Om1903/Design-and-Simulation-of-an-EEG-Alpha-Wave-Extraction-Circuit-with-Notch-Filtering/Final Schematic.asc

B2: bv; V =  200m + 500m * sin(2*pi*50*time)
B3: bv; V = 0
B4: bv; V =  200m + 500m * sin(2*pi*50*time)
C1: cap; 0.2µ
C2: cap; 1µ
C3: cap; 1µ
C4: cap; 0.2µ
C5: cap; 0.1µ
C6: cap; 0.1µ
C7: cap; 1µ
C8: cap; 1µ
C9: cap; 0.1µ
C10: cap; 0.1µ
C11: cap; 1µ
C12: cap; 1µ
C13: cap; 1µ
C14: cap; 1µ
C15: cap; 1µ
C16: cap; 1µ
C17: cap; 1µ
C18: cap; 1µ
C19: cap; 1µ
C20: cap; 1µ
C21: cap; 1µ
C22: cap; 1µ
C23: cap; 1µ
C24: cap; 1µ
C25: cap; 0.2µ
C26: cap; 0.1µ
C27: cap; 0.1µ
C28: cap; 1µ
C29: cap; 1µ
C30: cap; 1µ
C31: cap; 1µ
C32: cap; 1µ
C33: cap; 1µ
C34: cap; 1µ
C35: cap; 1µ
R1: res; 10k
R2: res; 10k
R3: res; 10k
R4: res; 25k
R5: res; 1k
R6: res; 586
R7: res; 25k
R8: res; 10k
R9: res; 10k
R10: res; 10k
R11: res; 10k
R12: res; 10k
R13: res; 10k
R14: res; 10k
R15: res; 10k
R16: res; 10k
R17: res; 5k
R18: res; 31.8k
R19: res; 31.8k
R20: res; 16.5k
R21: res; 58.4k
R22: res; 2.21k
R23: res; 10k
R24: res; 1k
R25: res; 10k
R26: res; 10k
R27: res; 118k
R28: res; 10k
R29: res; 10k
R30: res; 10k
R31: res; 1k
R32: res; 10k
R33: res; 31.8k
R34: res; 31.8k
R35: res; 16.5k
R36: res; 25k
R37: res; 1k
R38: res; 10k
R39: res; 10k
R40: res; 586
R41: res; 1k
R42: res; 10k
R43: res; 10k
R44: res; 586
R45: res; 1k
R46: res; 586
R47: res; 25k
R48: res; 28k
R49: res; 1k
R50: res; 10k
R51: res; 7.5k
R52: res; 7.5k
R53: res; 10k
R54: res; 1k
R55: res; 25k
R56: res; 1k
R57: res; 1k
R58: res; 25k
R59: res; 5k
R60: res; 1k
R61: res; 1k
R62: res; 10k
R63: res; 10k
R64: res; 10k
R65: res; 885
R66: res; 185k
R67: res; 43.3k
R68: res; 1.34k
R69: res; 302k
R70: res; 10k
R71: res; 10k
R72: res; 10k
R73: res; 10k
R74: res; 10k
R75: res; 10k
R76: res; 10k
R77: res; 1k
R78: res; 10k
R79: res; 31.8k
R80: res; 31.8k
R81: res; 16.5k
R82: res; 10k
R83: res; 586
R84: res; 1k
R85: res; 10k
R86: res; 10k
R87: res; 10k
R88: res; 586
R89: res; 1k
R90: res; 25k
R91: res; 1k
R92: res; 586
R93: res; 25k
R94: res; 500
R95: res; 1k
R96: res; 20k
R97: res; 10k
R98: res; 10k
R99: res; 10k
R100: res; 25k
R101: res; 1k
R102: res; 586
R103: res; 25k
U1: UniversalOpAmp2
U2: UniversalOpAmp2
U3: UniversalOpAmp2
U4: UniversalOpAmp2
U5: LT1013
U6: LT1013
U7: LT1013
U8: LT1013
U9: LT1013
U10: LT1013
U11: LT1013
U12: UniversalOpAmp2
U13: UniversalOpAmp2
U14: LT1013
U15: UniversalOpAmp2
U16: UniversalOpAmp2
U17: UniversalOpAmp2
U18: UniversalOpAmp2
U19: UniversalOpAmp2
U20: UniversalOpAmp2
U21: UniversalOpAmp2
U22: UniversalOpAmp2
U23: UniversalOpAmp2
U24: LT1013
U25: LT1013
U26: LT1013
U27: LT1013
U28: UniversalOpAmp2
U29: UniversalOpAmp2
U30: UniversalOpAmp2
U31: UniversalOpAmp2
U32: UniversalOpAmp2
U33: UniversalOpAmp2
U34: UniversalOpAmp2
V1: voltage; 0.15
V2: voltage; 15
V3: voltage; 15
V4: voltage; 1
V5: voltage; ""; AC 1 0
V6: voltage; 0.825
V7: voltage; 1
V8: voltage; ""; AC 1
V9: voltage; 0.075
V10: voltage; 1
V11: voltage; ""; AC 1
Named nets: 0, Vcc, Vee
.tran 0 2 0 1m
.ac dec 10 500m 100
